siarhei-t/lollipop-fm/hardware/lollipop-fm/lollipop-fm.kicad_pcb

## KiCad design hardware/lollipop-fm/lollipop-fm.kicad_pcb (2026-05-24)

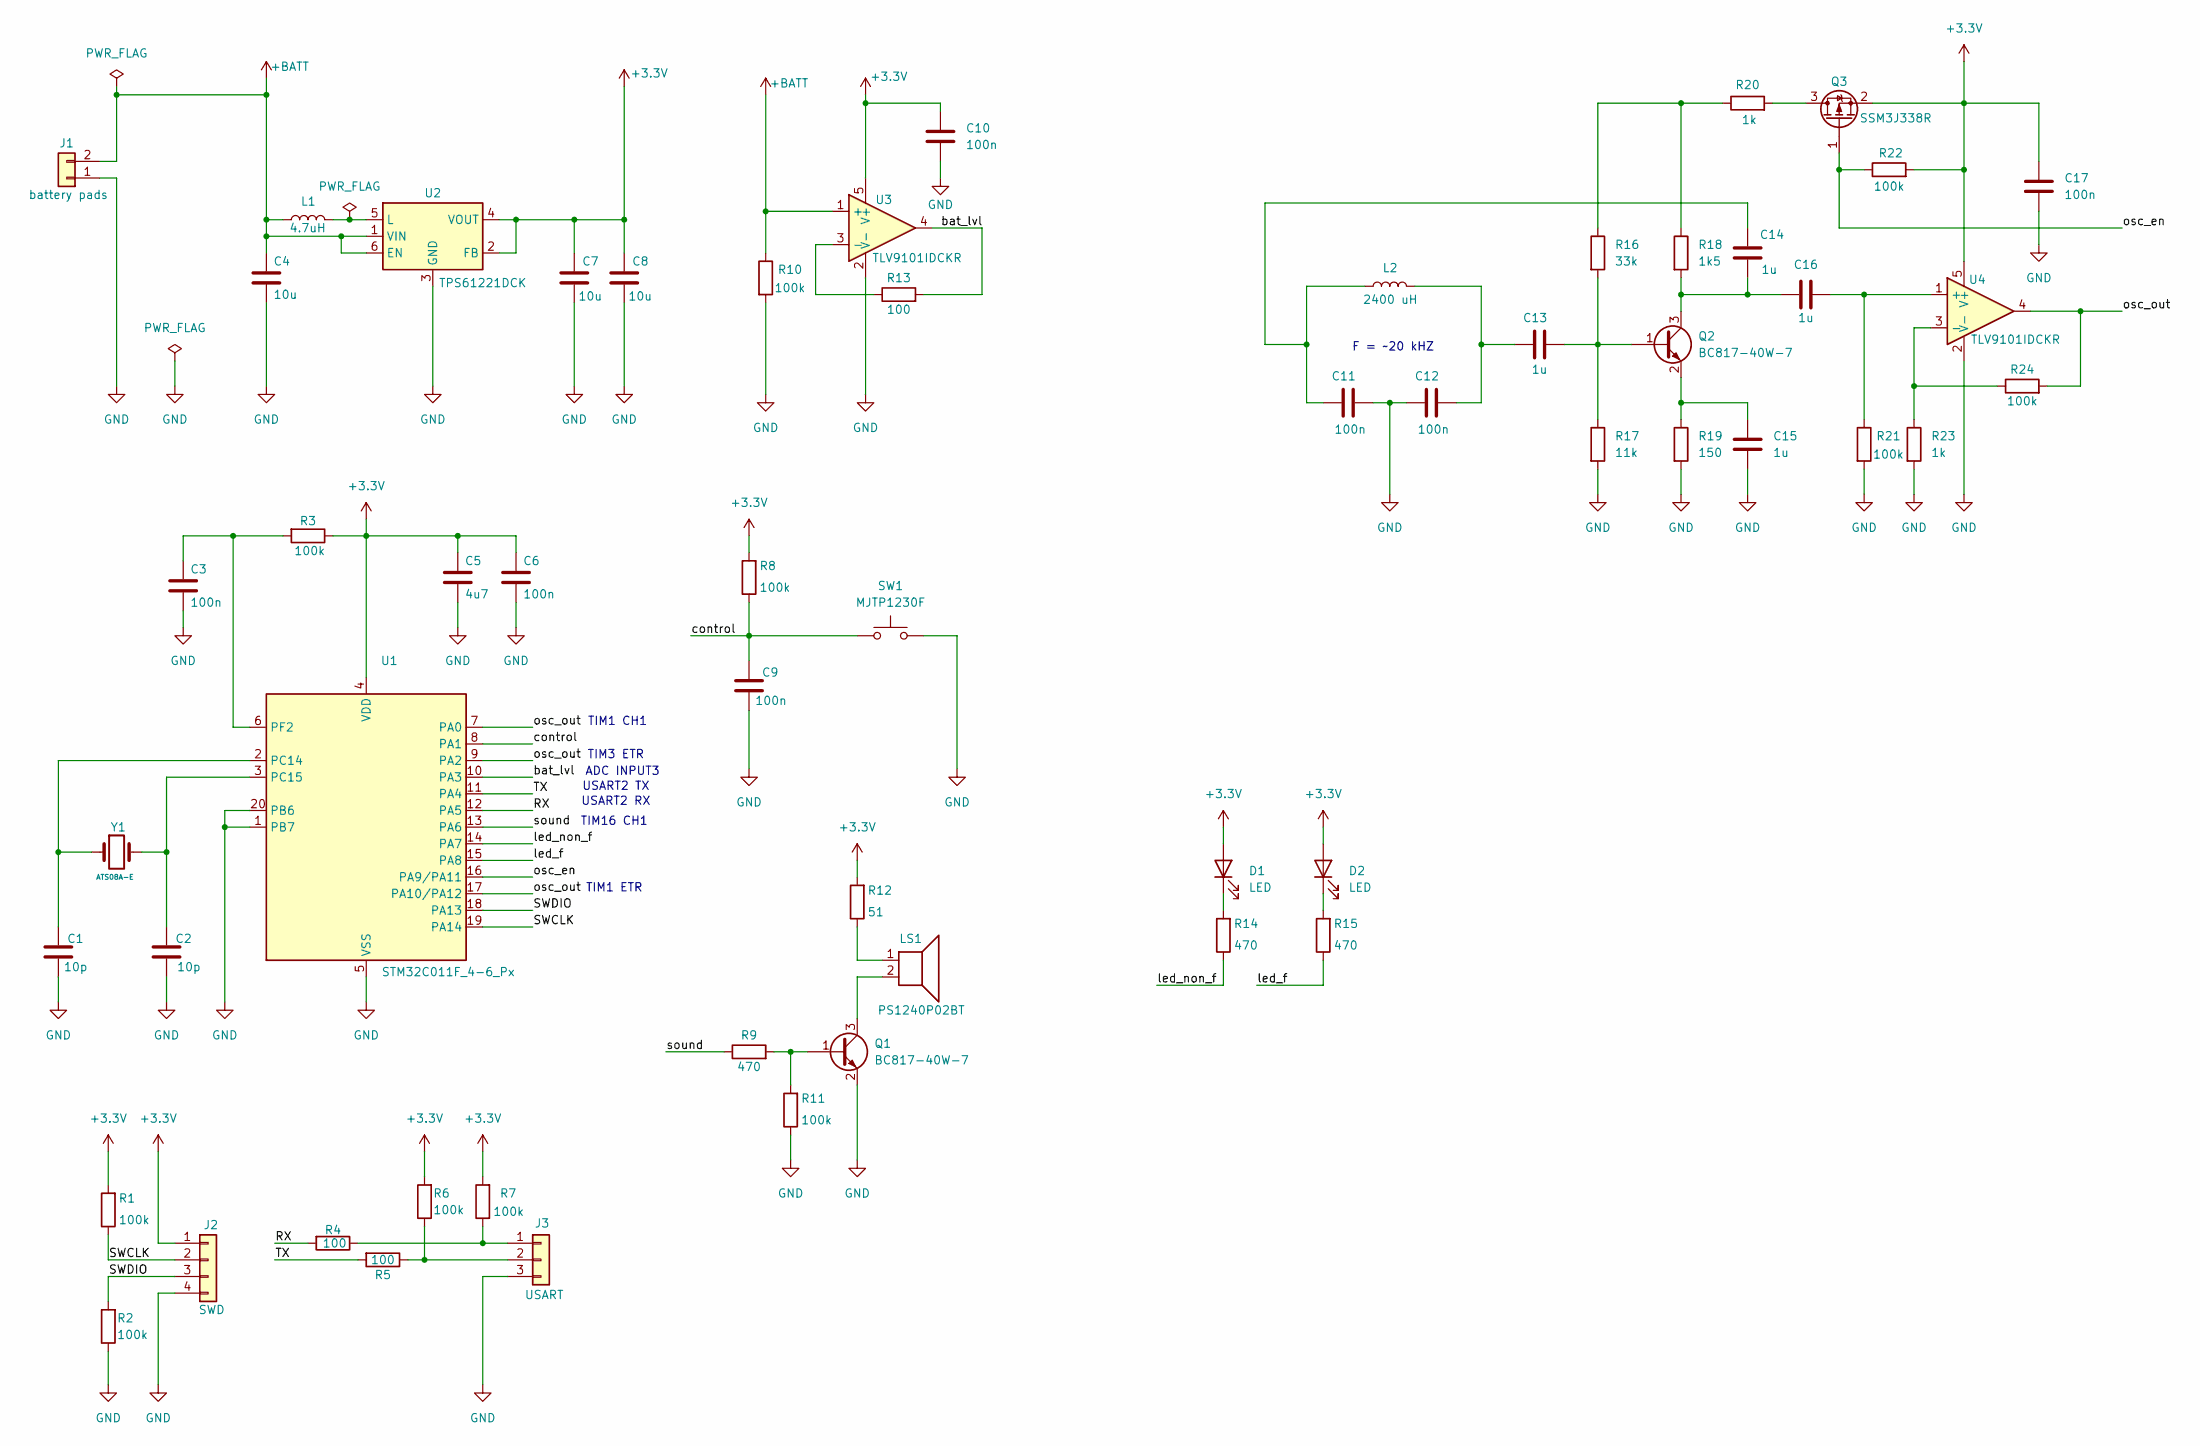
[picture p1: schematic lollipop-fm.kicad_sch]

Parts:
C1, C2: 10p; C_0603_1608Metric
C3, C6, C9, C10, C11, C12, C17: 100n; C_0603_1608Metric
C4, C7, C8: 10u; C_0603_1608Metric
C5: 4u7; C_0603_1608Metric
C13, C14, C15, C16: 1u; C_0603_1608Metric
D1, D2: LED; LED_D3.0mm
J1: battery pads; PinHeader_2x01_P2.54mm_Vertical
J2: SWD; pad-4-pin-2,54
J3: USART; pad-3-pin-2,54
L1: 4.7uH; L_0805_2012Metric
L2: 2400 uH; PinHeader_2x01_P2.54mm_Vertical
LS1: PS1240P02BT; Buzzer_12x9.5RM7.6
Q1, Q2: BC817-40W-7; SOT-323_SC-70_Handsoldering
Q3: SSM3J338R; SOT-23
R1, R2, R3, R6, R7, R8, R10, R11, R21, R22, R24: 100k; R_0603_1608Metric
R4, R5, R13: 100; R_0603_1608Metric
R9, R14, R15: 470; R_0603_1608Metric
R12: 51; R_0603_1608Metric
R16: 33k; R_0603_1608Metric
R17: 11k; R_0603_1608Metric
R18: 1k5; R_0603_1608Metric
R19: 150; R_0603_1608Metric
R20, R23: 1k; R_0603_1608Metric
SW1: MJTP1230F; SW_PUSH_6mm
U1: STM32C011F_4-6_Px; TSSOP-20_4.4x6.5mm_P0.65mm
U2: TPS61221DCK; Texas_R-PDSO-G6
U3, U4: TLV9101IDCKR; SOT-353_SC-70-5_Handsoldering
Y1: ATS08A-E; Crystal_HC49-4H_Vertical

Connections:
+3.3V: C5.1, C6.1, C7.2, C8.2, C10.1, C17.1, D1.2 (A), D2.2 (A), J2.1, Q3.2, R1.2, R3.1, R6.2, R7.2, R8.2, R12.2, R22.2, U1.4 (VDD), U2.2 (FB), U2.4 (VOUT), U3.5 (V+), U4.5 (V+)
+BATT: C4.1, J1.2, L1.1, R10.1, U2.1 (VIN), U2.6 (EN), U3.1 (+)
/RX: R4.2, U1.12 (PA5)
/SWCLK: J2.2, R1.1, U1.19 (PA14)
/SWDIO: J2.3, R2.2, U1.18 (PA13)
/TX: R5.2, U1.11 (PA4)
/bat_lvl: R13.2, U1.10 (PA3), U3.4
/control: C9.2, R8.1, SW1.1, U1.8 (PA1)
/led_f: R15.1, U1.15 (PA8)
/led_non_f: R14.1, U1.14 (PA7)
/osc_en: Q3.1, R22.1, U1.16 (PA9/PA11)
/osc_out: R24.2, U1.7 (PA0), U1.9 (PA2), U1.17 (PA10/PA12), U4.4
/sound: R9.1, U1.13 (PA6)
GND: C1.2, C2.2, C3.2, C4.2, C5.2, C6.2, C7.1, C8.1, C9.1, C10.2, C11.2, C12.1, C15.2, C17.2, J1.1, J2.4, J3.3, Q1.2 (E), R2.1, R10.2, R11.1, R17.2, R19.2, R21.2, R23.2, SW1.2, U1.1 (PB7), U1.5 (VSS), U1.20 (PB6), U2.3 (GND), U3.2 (V-), U4.2 (V-)
unnamed: C11.1, C14.1, L2.1
unnamed: C12.2, C13.1, L2.2
unnamed: D1.1 (K), R14.2
unnamed: D2.1 (K), R15.2
unnamed: J3.1, R4.1, R7.1
unnamed: J3.2, R5.1, R6.1
unnamed: LS1.1, R12.1
unnamed: Q1.1 (B), R9.2, R11.2
unnamed: LS1.2, Q1.3 (C)
unnamed: C13.2, Q2.1 (B), R16.2, R17.1
unnamed: C14.2, C16.1, Q2.3 (C), R18.2
unnamed: C15.1, Q2.2 (E), R19.1
unnamed: Q3.3, R20.2
unnamed: R16.1, R18.1, R20.1
unnamed: C1.1, U1.2 (PC14), Y1.1
unnamed: C2.1, U1.3 (PC15), Y1.2
unnamed: C3.1, R3.2, U1.6 (PF2)
unnamed: L1.2, U2.5 (L)
unnamed: R13.1, U3.3 (-)
unnamed: C16.2, R21.1, U4.1 (+)
unnamed: R23.1, R24.1, U4.3 (-)

Notes on the sheet:
ADC INPUT3
TIM1 CH1
USART2 TX
F = ~20 kHZ
USART2 RX
TIM1 ETR
TIM16 CH1
TIM3 ETR

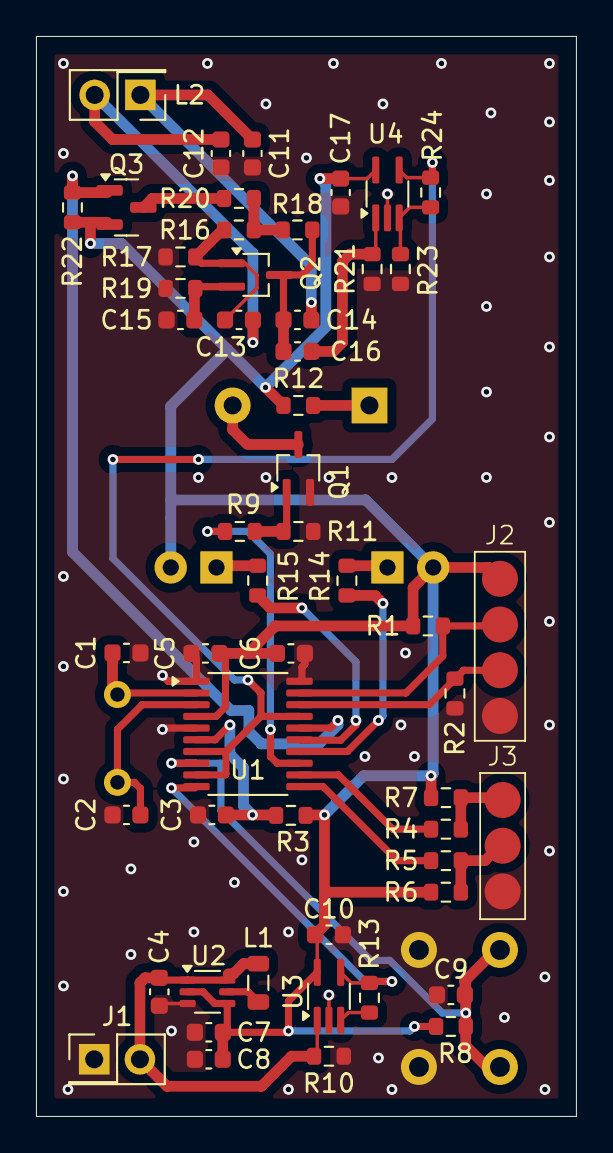
[picture p2: board lollipop-fm.kicad_pcb from above]

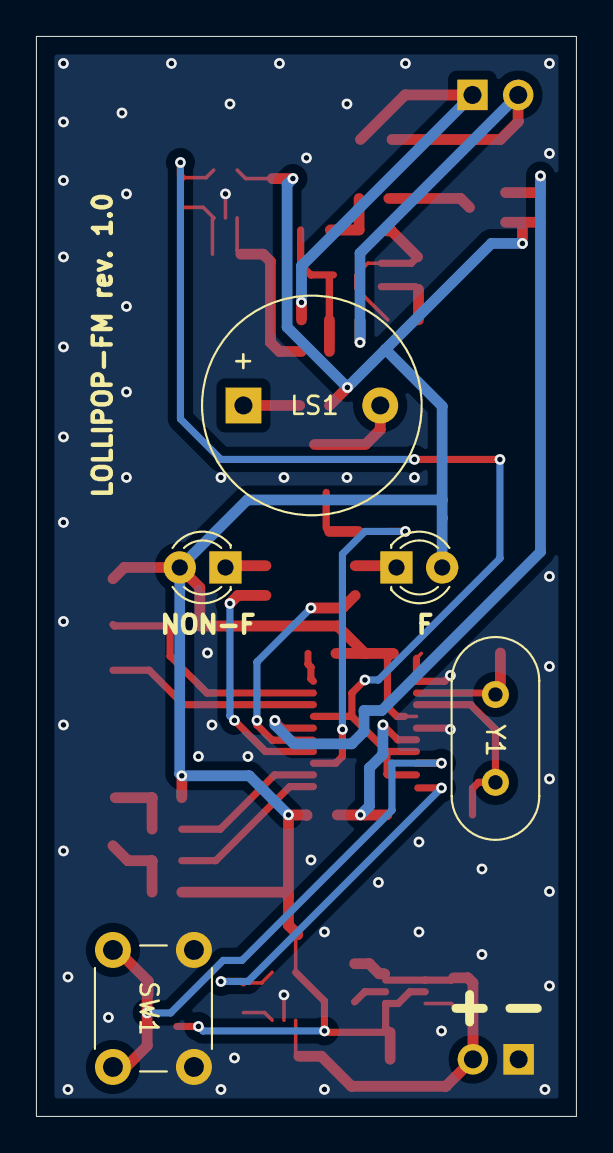
[picture p3: board lollipop-fm.kicad_pcb from below]

Board: 2 copper layers, 30.0 x 60.0 mm, 58 parts (5 on the bottom side), 35 nets.
