siarhei-t/lollipop-fm/firmware/src/main.cpp

/**
 * @file main.cpp
 *
 * @brief tbd
 *
 *
 */

/* Includes ----------------------------------------------------------------- */

#include "app.hpp"

/* Public functions --------------------------------------------------------- */

int main(void)
{
    app::Application& app = app::Application::instance();
    app.start();
    vTaskStartScheduler();
    // normally unreachable
    for (;;)
    {
    }
}

/* configUSE_STATIC_ALLOCATION is set to 1, so the application must provide an
 * implementation of vApplicationGetIdleTaskMemory() to provide the memory that is
 * used by the Idle task. */
void vApplicationGetIdleTaskMemory(StaticTask_t** ppxIdleTaskTCBBuffer, StackType_t** ppxIdleTaskStackBuffer, uint32_t* pulIdleTaskStackSize)
{
    static StaticTask_t xIdleTaskTCB;
    static StackType_t uxIdleTaskStack[configMINIMAL_STACK_SIZE];
    *ppxIdleTaskTCBBuffer = &xIdleTaskTCB;
    *ppxIdleTaskStackBuffer = uxIdleTaskStack;
    *pulIdleTaskStackSize = configMINIMAL_STACK_SIZE;
}

/**
 * @brief This is to provide the memory that is used by the RTOS daemon/time task.
 *
 * If configUSE_STATIC_ALLOCATION is set to 1, so the application must provide an
 * implementation of vApplicationGetTimerTaskMemory() to provide the memory that is
 * used by the RTOS daemon/time task.
 */
void vApplicationGetTimerTaskMemory(StaticTask_t** ppxTimerTaskTCBBuffer, StackType_t** ppxTimerTaskStackBuffer, uint32_t* pulTimerTaskStackSize)
{

    static StaticTask_t xTimerTaskTCB;
    static StackType_t uxTimerTaskStack[configTIMER_TASK_STACK_DEPTH];
    *ppxTimerTaskTCBBuffer = &xTimerTaskTCB;
    *ppxTimerTaskStackBuffer = uxTimerTaskStack;
    *pulTimerTaskStackSize = configTIMER_TASK_STACK_DEPTH;
}

void vApplicationStackOverflowHook(TaskHandle_t, char*)
{
    taskDISABLE_INTERRUPTS();
    while (1)
    {
    }
}

/* ------------------------------ end of file ------------------------------- */
