siarhei-t/lollipop-fm/firmware/inc/config.hpp

/**
 * @file config.hpp
 *
 * @brief
 *
 */

#ifndef CONFIG_H
#define CONFIG_H

namespace cfg
{
////////////////////////DETECTOR SETTINGS AND CONSTANTS/////////////////////////////
constexpr int log_period_ms = 2000;                         // if project build with serial port support
constexpr int update_rate_ms = 50;                          // the period at which the frequency meter is polled
constexpr int initial_num_of_samples = 20;                  // the number of frequency meter measurements to obtain the average value during calibration
constexpr int allowable_deviation = 1;                      // maximum permitted deviation in absolute values of the timer counter
constexpr int num_of_deviations = 2;                        // maximum number of consecutive deviations permitted
constexpr int log_timeout = log_period_ms / update_rate_ms; // period for serial port output
////////////////////////////////////////////////////////////////////////////////
} // namespace cfg

#endif // CONFIG_H
