siarhei-t/lollipop-fm/firmware/src/main.c

/**
 * @file main.c
 *
 * @brief tbd
 *
 *
 */

/* Includes ----------------------------------------------------------------- */

/* Public functions --------------------------------------------------------- */

int main(void)
{
    for (;;)
    {
    }
}

/* ------------------------------ end of file ------------------------------- */
