siarhei-t/lollipop-fm/(commit log)

2025-12-29 - added CMSIS device support and linker script for stm32c011
2026-01-01 - build switched to C++ application
2026-01-02 - added led control, added first FreeRTOS task for led control
2026-01-03 - led control switched to static task logic
2026-01-04 - added main task, console print tested
2026-01-07 - RTOS stack usage fixed
    [app.cpp, app.hpp, frequency_meter.cpp, led.hpp, main.cpp, serial.cpp]
2026-01-07 - system switched to internal clock
2026-01-07 - hardware tested, first version of colpitts oscillator works
    [app.cpp, frequency_meter.cpp]
2026-01-09 - added calibration request on button press event
2026-01-09 - manual calibration tested
2026-01-09 - added empty files for buzzer control
    [buzzer.cpp, buzzer.hpp]
2026-01-18 - added empty buzzer task
    [app.cpp, buzzer.cpp, buzzer.hpp, led.hpp]
2026-01-19 - buzzer to be fixed for one tone usage, led will be only one
    [app.cpp, buzzer.cpp, buzzer.hpp]
2026-02-01 - added empty hardware project
    [lollipop-fm.kicad_pcb, lollipop-fm.kicad_sch]
2026-03-15 - imported old schematic
    [lollipop-fm.kicad_sch]
2026-03-15 - schematic updated with latest changes
    [lollipop-fm.kicad_pcb, lollipop-fm.kicad_sch]
2026-03-16 - new routing added
    [lollipop-fm.kicad_pcb, lollipop-fm.kicad_sch]
2026-03-17 - production files generated
    [lollipop-fm.kicad_pcb]
2026-04-19 - led control logic updated, schematic naming updated
    [lollipop-fm.kicad_pcb, lollipop-fm.kicad_sch]
2026-04-26 - buzzer logic refactored
    [buzzer.cpp, buzzer.hpp, led.cpp, led.hpp]
2026-05-23 - new board tested
2026-05-23 - to be switched to the old buzzer
    [app.cpp]
